TMakins/CDH_I2C_Interface/Schematic/Schematic.pdf

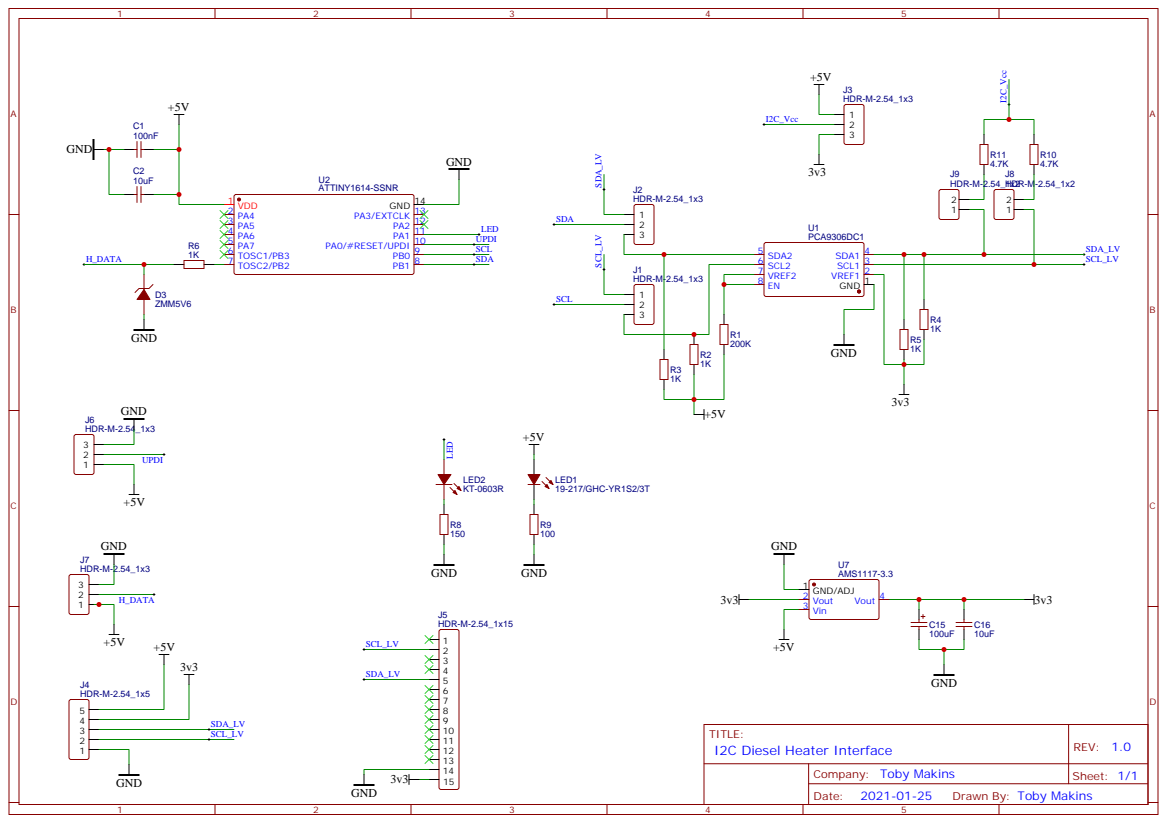
[picture p2: page 1]

Drawn By: Toby Makins
