TMakins/CDH_I2C_Interface/(threads)

Thread 1 (2022-02-14):

Interface module

bakermanus, 2022-02-14:
Hi,
I'm wondering if you still have interface module available?
Thanks

knockoutperformance, 2022-03-12:
Sweet work on the heater!
Do you have an interface module available also?
Thank you for your time.

irdispsyhonikum, 2022-06-05:
hello.

Can I also get one, please?
Great job.

Kind regards

TMakins, 2022-11-03:
Sorry for the slow reply, I tend to go a bit offline most of the summer!

I've updated the readme and added eBay links to purchase the modules. Note these aren't programmed as I just don't have the time, but should be simple enough to program with an Arduino acting as a UPDI programmer.

Closed 2022-11-03.

Thread 2 (2022-11-12):

cannoct make it work.

irdispsyhonikum, 2022-11-12:
Hello.

I bought your module and connected it to esp32-e. But it don't working. Remote control showing arrows behind pipe picture. To be honest not shore whe the problem is. Can you please help me to find the solution and fix this?

Kind regards
Irdis

P.S. Esp show's the screen, but data not get updatad, and pressing on stop area, only gets boarder yellow for few secconds. both lights are lighting.

TMakins, 2022-11-12:
First thing to check is if you have comms with the interface board itself, I would suggest writing some code that just sets up I2C and reads the version reg (addr 34). If that works, we can move onto the heater comms side.

irdispsyhonikum, 2022-11-13:
Helo.

Sorry to did not reply strait away. Yes, I was thinking to scheck same way. will check it 2mo morning after work. But before may I ask another one quastion. Do I have to place middle jumpers? I do not understand for what they are. 3v3 pover exist on the pin.

irdispsyhonikum, 2022-11-13:
Hello TMakins,

I checked if esp32 board seas any information from your controller, and unswer is yes. So can be problemm esewhere.

Kind regards
Irdis

irdispsyhonikum, 2022-11-13:
And sorry, but I should as again about the jumpers with voltage on the middle. The information on the board and Yours picture voltage little bit comfusig me.

irdispsyhonikum, 2022-11-13:
I think I've sorted. I placed Jumpers wrongly as on the picture for (3v3 picture, 5v board), and when tested output voltege wa 4.1. then I changed jumper to (3v3 board, 5v picture), then everithing get's on place. Sorry for opening case. Should ment it first.
