TMakins/CDH_I2C_Interface/(commit log)

2021-02-26 Added status bit to indicate when device is ready
    Doesn't really do anything, as it's true immediately after I2C is setup, but at least if the status byte has meaningful data then it indicates the I2C is running correctly
    [heater.cpp, main.cpp]
2021-03-02 Added OTA debug Arduino sketch
2021-03-03 Made i2c_regs extern and removed pointer passing
2021-03-07 Added interpreted states, reset reason and basic fault protection
    [heater.cpp, heater.h]
2021-03-10 Removed local i2c_regs
2021-03-13 Removed Arduino sketch
